whtech-nl/tinyODIN/project/image.v

reg [3:0] image [0:15][0:15];
initial begin
    image = '{
        '{4'd0,4'd0,4'd0,4'd0,4'd0,4'd0,4'd0,4'd0,4'd0,4'd0,4'd0,4'd0,4'd0,4'd0,4'd0,4'd0},
        '{4'd0,4'd0,4'd0,4'd0,4'd0,4'd0,4'd0,4'd0,4'd0,4'd0,4'd0,4'd0,4'd0,4'd0,4'd0,4'd0},
        '{4'd0,4'd0,4'd0,4'd0,4'd0,4'd0,4'd0,4'd0,4'd0,4'd0,4'd0,4'd0,4'd0,4'd0,4'd0,4'd0},
        '{4'd0,4'd0,4'd0,4'd0,4'd0,4'd1,4'd7,4'd4,4'd6,4'd5,4'd1,4'd0,4'd0,4'd0,4'd0,4'd0},
        '{4'd0,4'd0,4'd0,4'd0,4'd5,4'd4,4'd5,4'd5,4'd6,4'd8,4'd7,4'd2,4'd0,4'd0,4'd0,4'd0},
        '{4'd0,4'd0,4'd0,4'd0,4'd0,4'd0,4'd0,4'd0,4'd0,4'd5,4'd6,4'd4,4'd0,4'd0,4'd0,4'd0},
        '{4'd0,4'd0,4'd0,4'd0,4'd0,4'd0,4'd0,4'd0,4'd0,4'd3,4'd6,4'd0,4'd0,4'd0,4'd0,4'd0},
        '{4'd0,4'd0,4'd0,4'd0,4'd0,4'd0,4'd0,4'd1,4'd4,4'd6,4'd1,4'd0,4'd0,4'd0,4'd0,4'd0},
        '{4'd0,4'd0,4'd0,4'd0,4'd0,4'd3,4'd11,4'd6,4'd3,4'd6,4'd10,4'd0,4'd0,4'd0,4'd0,4'd0},
        '{4'd0,4'd0,4'd0,4'd0,4'd0,4'd0,4'd0,4'd0,4'd0,4'd1,4'd1,4'd0,4'd0,4'd0,4'd0,4'd0},
        '{4'd0,4'd0,4'd0,4'd0,4'd0,4'd0,4'd0,4'd0,4'd0,4'd0,4'd1,4'd1,4'd0,4'd0,4'd0,4'd0},
        '{4'd0,4'd0,4'd0,4'd0,4'd0,4'd2,4'd0,4'd0,4'd0,4'd0,4'd10,4'd3,4'd0,4'd0,4'd0,4'd0},
        '{4'd0,4'd0,4'd0,4'd0,4'd2,4'd3,4'd5,4'd4,4'd3,4'd6,4'd7,4'd0,4'd0,4'd0,4'd0,4'd0},
        '{4'd0,4'd0,4'd0,4'd0,4'd0,4'd2,4'd11,4'd5,4'd6,4'd1,4'd0,4'd0,4'd0,4'd0,4'd0,4'd0},
        '{4'd0,4'd0,4'd0,4'd0,4'd0,4'd0,4'd0,4'd0,4'd0,4'd0,4'd0,4'd0,4'd0,4'd0,4'd0,4'd0},
        '{4'd0,4'd0,4'd0,4'd0,4'd0,4'd0,4'd0,4'd0,4'd0,4'd0,4'd0,4'd0,4'd0,4'd0,4'd0,4'd0}
    };
end
